watt-city/autonomous-stoplight/pcb_updates/katie_tao_stoplight/production/bom.csv

Designator | Footprint | Quantity | Value | LCSC Part #
C301, C402 | 0603 | 2 | 10u | C19702
C302, C304, C305 | 0603 | 3 | 100n | C14663
C303 | 0603 | 1 | 1u | C15849
C401 | 0805 | 1 | 4.7u | C1779
D201, D401, D402 | D_SOD-323_HandSoldering | 3 | 600m | C191023
D301 | 0805 | 1 | Green | C2297
D302 | 0603 | 1 | Red | C2286
D303 | 0805 | 1 | Yellow | C2296
J201 | USB4110-GF-A_GCT | 1 | USB4110-GF-A
J401 | CONN_S2B-PH-K-S_JST | 1 | S2B-PH-K-SLFSN
R201, R202 | 0805 | 2 | 5.1k | C27834
R301, R302, R303 | 0603 | 3 | 10k | C25804
R304 | 0805 | 1 | 47 | C17714
R305, R306 | 0805 | 2 | 120 | C17437
S301, S302, S303 | SW_TS-1088-AR02016 | 3 | TS-1088-AR02016
SW401 | 500SSP1_EWI | 1 | 500SSP1S2M2QEA
TP101 | TestPoint_Keystone_5019_Miniature | 1 | GND Test Point | C5199800
TP105 | TestPoint_Keystone_5019_Miniature | 1 | 3V3 Test Point | C5199800
TP201 | TestPoint_Keystone_5019_Miniature | 1 | USB Test Point | C5199800
TP401 | TestPoint_Keystone_5019_Miniature | 1 | LiPo Test Point | C5199800
U201 | SOT-23 | 1 | SLLC23T5V2U
U301 | ESP32-S3-WROOM-1_EXP | 1 | ESP32-S3-WROOM-1-N8
U401 | SOT-23-5 | 1 | AP2112K-3.3
