watt-city/autonomous-stoplight/pcb_updates/katie_tao_stoplight/katie_tao_stoplight.kicad_pcb

## KiCad design pcb_updates/katie_tao_stoplight/katie_tao_stoplight.kicad_pcb (2026-11-05)

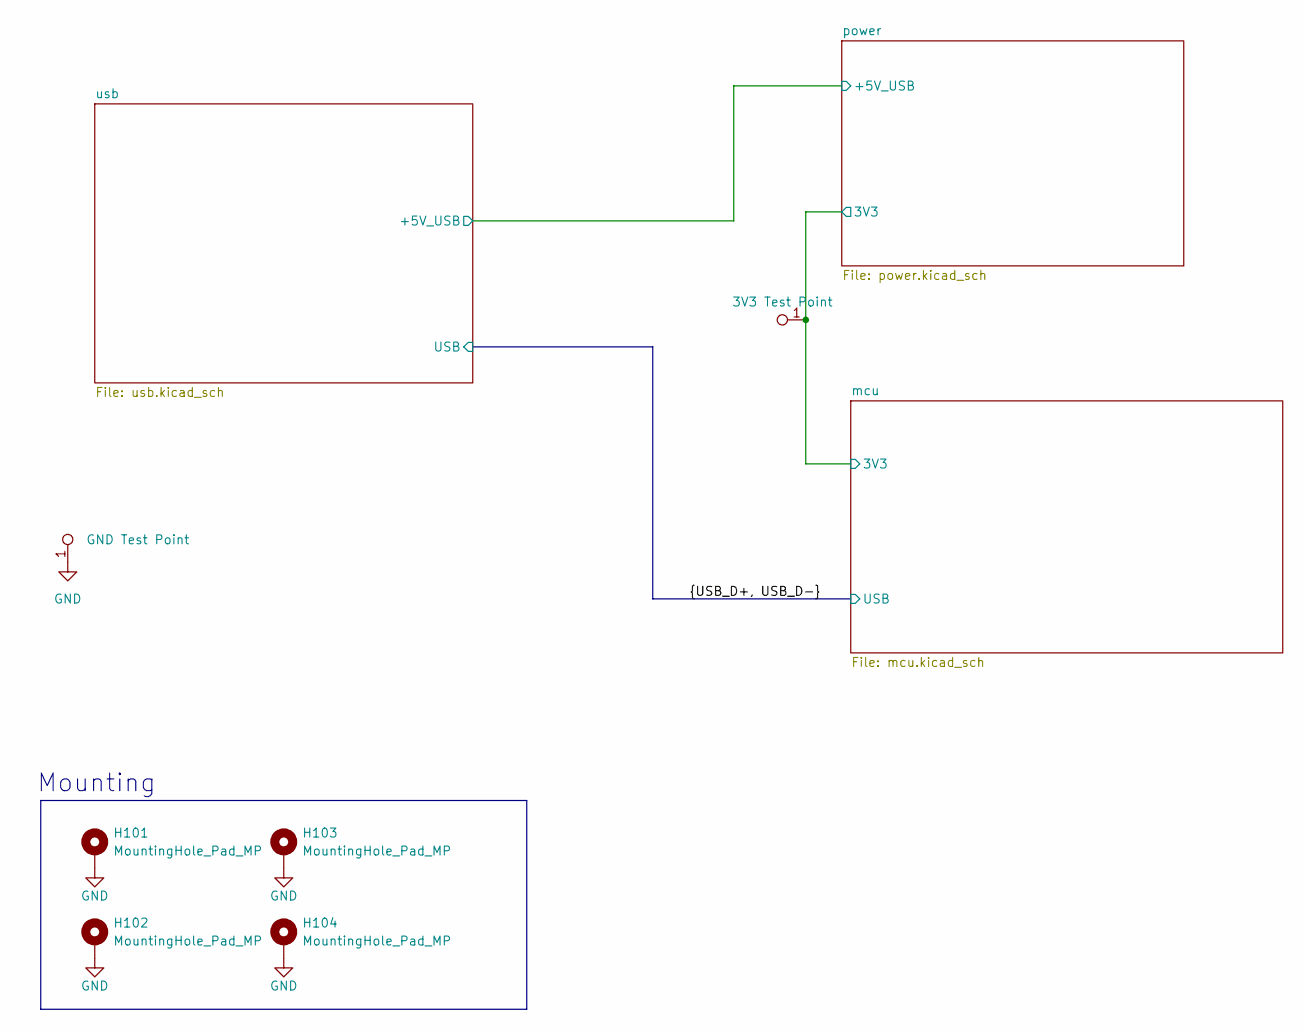
[picture p1: schematic katie_tao_stoplight.kicad_sch]

Parts:
H101, H102, H103, H104: MountingHole_Pad_MP; MountingHole_2.7mm_M2.5_Pad_Via; Mouser P/N N/A; Digikey P/N N/A
TP101: GND Test Point; TestPoint_Keystone_5019_Miniature; Manufacturer P/N RH-5019; Digikey P/N 36-5019CT-ND
TP105: 3V3 Test Point; TestPoint_Keystone_5019_Miniature; Manufacturer P/N RH-5019; Digikey P/N 36-5019CT-ND

Connections:
/mcu/3V3: TP105.1; also elsewhere on the board
GND: H101.1 (1_1), H102.1 (1_1), H103.1 (1_1), H104.1 (1_1), TP101.1; also elsewhere on the board

Notes on the sheet:
Mounting

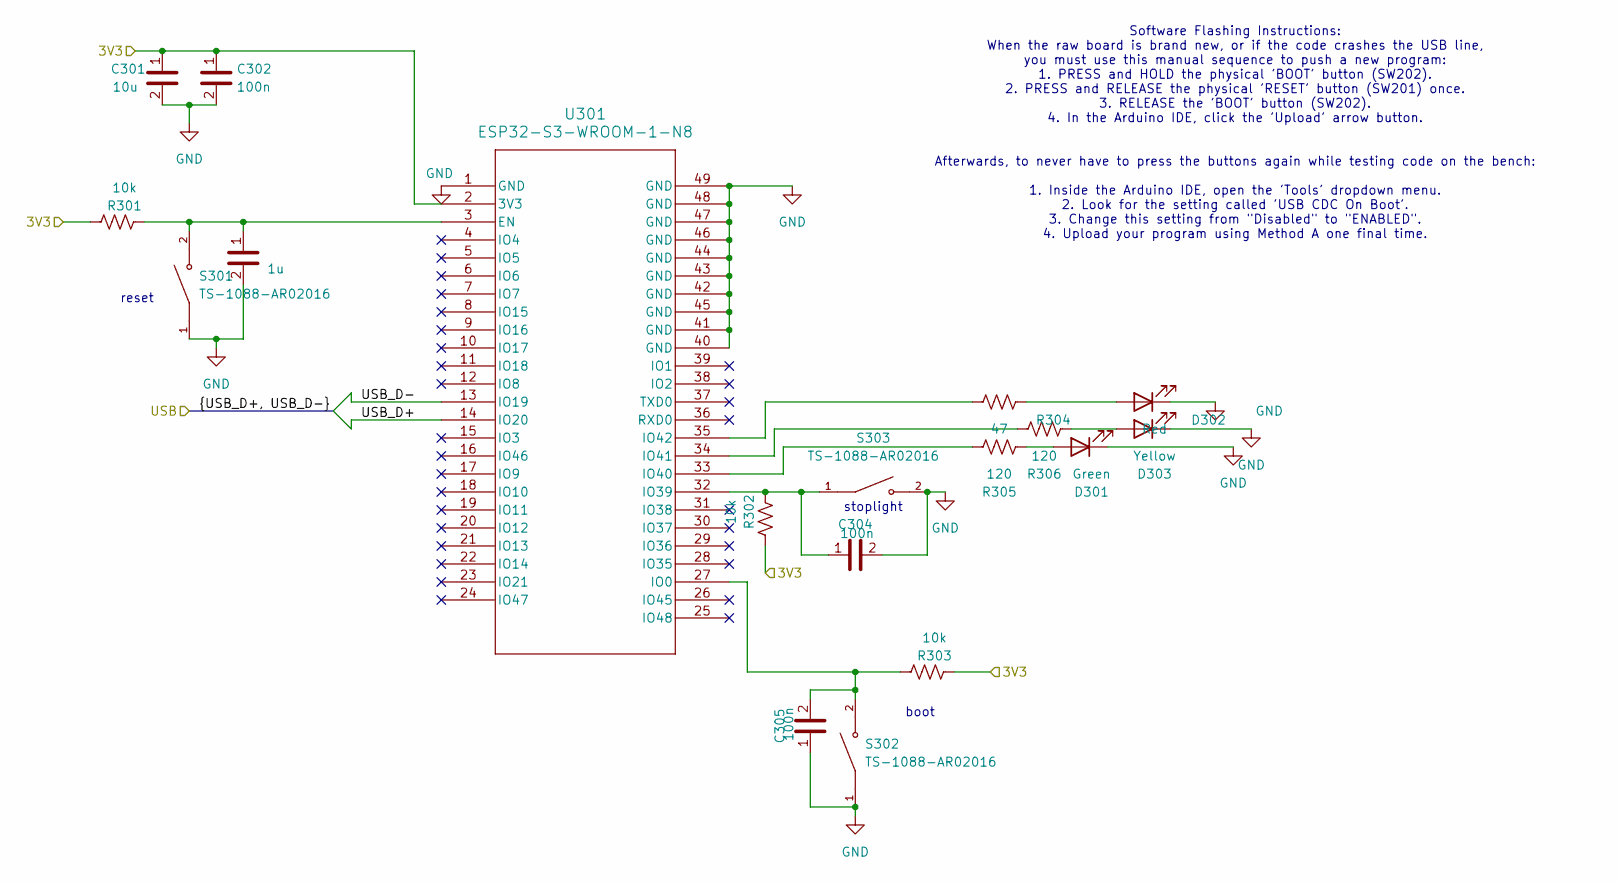
[picture p2: schematic mcu.kicad_sch]

Parts:
C301: 10u; C_0603_1608Metric_Pad1.08x0.95mm_HandSolder; LCSC P/N C19702
C302, C304, C305: 100n; C_0603_1608Metric_Pad1.08x0.95mm_HandSolder; Mouser P/N 581-06035C104KAT2A; Digikey P/N 478-KGM15BR71H104KTCT-ND
C303: 1u; C_0603_1608Metric_Pad1.08x0.95mm_HandSolder; LCSC P/N C15849
D301: Green; D_0805_2012Metric_Pad1.15x1.40mm_HandSolder; Mouser P/N 755-SMLMN2ECTT86C; Digikey P/N 846-SMLMN2ECTT86CCT-ND
D302: Red; D_0603_1608Metric_Pad1.05x0.95mm_HandSolder; Mouser P/N 720-LRQ976.01; Digikey P/N 475-LRQ976.01-P2R2-1CT-ND
D303: Yellow; D_0805_2012Metric_Pad1.15x1.40mm_HandSolder; Mouser P/N 645-599-0140-007F; Digikey P/N 350-4356-1-ND
R301, R302, R303: 10k; R_0603_1608Metric_Pad0.98x0.95mm_HandSolder; Mouser P/N 708-RMCF0603FT10K0; Digikey P/N RMCF0603FT10K0CT-ND
R304: 47; R_0805_2012Metric_Pad1.20x1.40mm_HandSolder; Mouser P/N 708-RMCF0805FT47R0; Digikey P/N RMCF0805FT47R0CT-ND
R305, R306: 120; R_0805_2012Metric_Pad1.20x1.40mm_HandSolder; Mouser P/N 708-RMCF0805FT120R; Digikey P/N RMCF0805FT120RCT-ND
S301, S302, S303: TS-1088-AR02016; SW_TS-1088-AR02016; PARTREV N/A
U301: ESP32-S3-WROOM-1-N8; ESP32-S3-WROOM-1_EXP

Connections:
/USB_D+: U301.14 (IO20); also elsewhere on the board
/USB_D-: U301.13 (IO19); also elsewhere on the board
/mcu/3V3: C301.1, C302.1, R301.1, R302.1, R303.2, U301.2 (3V3); also elsewhere on the board
GND: C301.2, C302.2, C303.2, C304.2, C305.1, D301.1 (K), D302.1 (K), D303.1 (K), S301.1, S302.1, S303.2, U301.1 (GND), U301.40 (GND), U301.41 (GND), U301.42 (GND), U301.43 (GND), U301.44 (GND), U301.45 (GND), U301.46 (GND), U301.47 (GND), U301.48 (GND), U301.49 (GND); also elsewhere on the board
unnamed: D301.2 (A), R305.1
unnamed: D302.2 (A), R304.1
unnamed: D303.2 (A), R306.1
unnamed: C303.1, R301.2, S301.2, U301.3 (EN)
unnamed: C305.2, R303.1, S302.2, U301.27 (IO0)
unnamed: C304.1, R302.2, S303.1, U301.32 (IO39)
unnamed: R305.2, U301.33 (IO40)
unnamed: R306.2, U301.34 (IO41)
unnamed: R304.2, U301.35 (IO42)

Notes on the sheet:
reset
Software Flashing Instructions: When the raw board is brand new, or if the code crashes the USB line, you must use this manual sequence to push a new program: 1. PRESS and HOLD the physical 'BOOT' button (SW202). 2. PRESS and RELEASE the physical 'RESET' button (SW201) once. 3. RELEASE the 'BOOT' b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
boot
stoplight

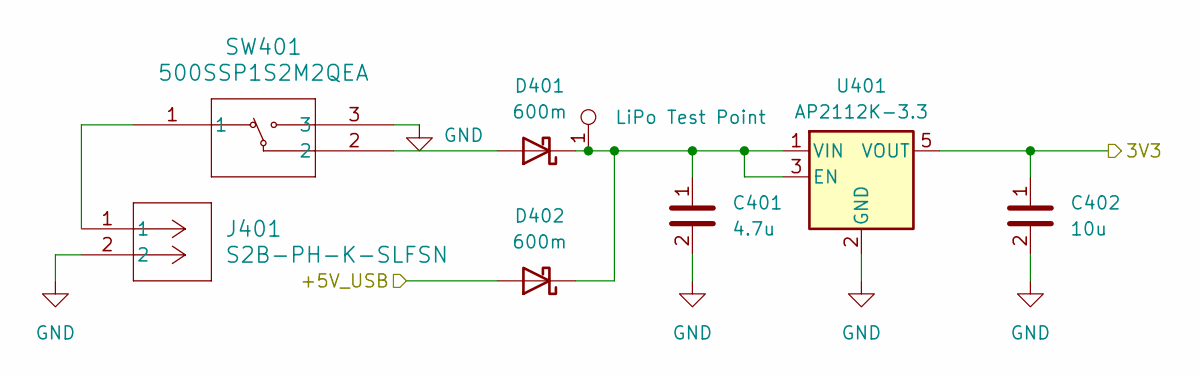
[picture p3: schematic power.kicad_sch]

Parts:
C401: 4.7u; C_0805_2012Metric_Pad1.18x1.45mm_HandSolder; Mouser P/N 581-KGM21AR51A475KU; Digikey P/N 478-KGM21AR51A475KUCT-ND
C402: 10u; C_0603_1608Metric_Pad1.08x0.95mm_HandSolder; LCSC P/N C19702
D401, D402: 600m; D_SOD-323_HandSoldering; Mouser P/N 833-B5819WS-TP; LCSC P/N C191023
J401: S2B-PH-K-SLFSN; CONN_S2B-PH-K-S_JST
SW401: 500SSP1S2M2QEA; 500SSP1_EWI
TP401: LiPo Test Point; TestPoint_Keystone_5019_Miniature; Manufacturer P/N RH-5019; Digikey P/N 36-5019CT-ND
U401: AP2112K-3.3; SOT-23-5

Connections:
/mcu/3V3: C402.1, U401.5 (VOUT); also elsewhere on the board
/power/+5V_USB: D402.2 (A); also elsewhere on the board
GND: C401.2, C402.2, J401.2, SW401.3, U401.2 (GND); also elsewhere on the board
unnamed: D401.2 (A), SW401.2
unnamed: C401.1, D401.1 (K), D402.1 (K), TP401.1, U401.1 (VIN), U401.3 (EN)
unnamed: J401.1, SW401.1

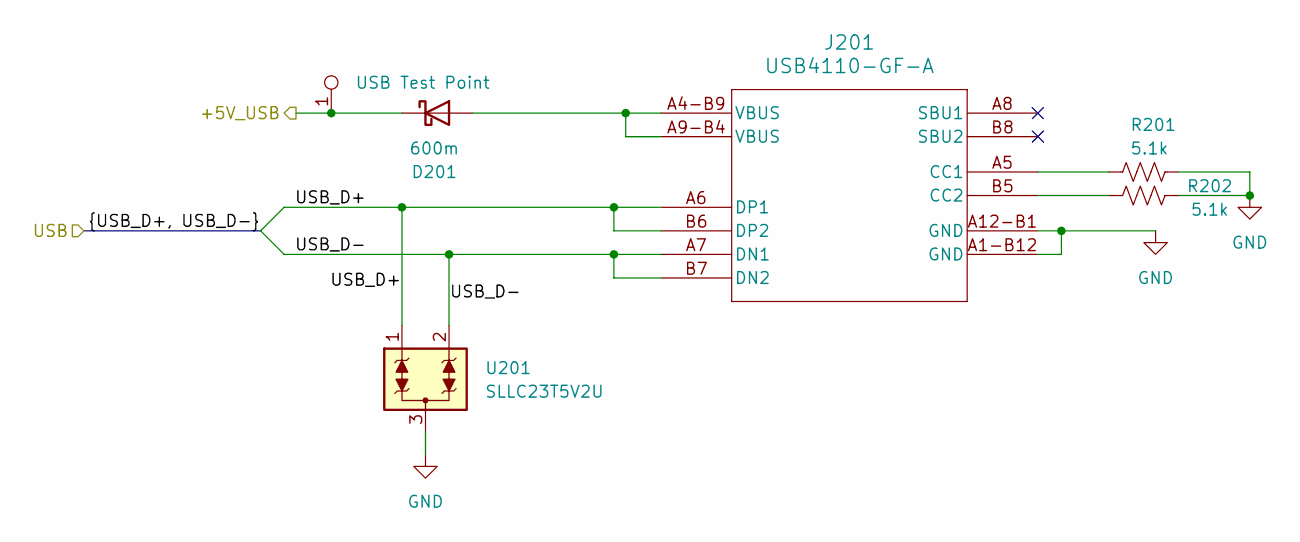
[picture p4: schematic usb.kicad_sch]

Parts:
D201: 600m; D_SOD-323_HandSoldering; Mouser P/N 833-B5819WS-TP; LCSC P/N C191023
J201: USB4110-GF-A; USB4110-GF-A_GCT
R201, R202: 5.1k; R_0805_2012Metric_Pad1.20x1.40mm_HandSolder; Mouser P/N 708-RMCF0805FT5K10; Digikey P/N RMCF0805FT5K10CT-ND
TP201: USB Test Point; TestPoint_Keystone_5019_Miniature; Manufacturer P/N RH-5019; Digikey P/N 36-5019CT-ND
U201: SLLC23T5V2U; SOT-23; Manufacturer P/N SLLC23T5V2U; Digikey P/N 5399-SLLC23T5V2UCT-ND

Connections:
/USB_D+: J201.A6 (DP1), J201.B6 (DP2), U201.1; also elsewhere on the board
/USB_D-: J201.A7 (DN1), J201.B7 (DN2), U201.2; also elsewhere on the board
/power/+5V_USB: D201.1 (K), TP201.1; also elsewhere on the board
GND: J201.A1-B12 (GND), J201.A12-B1 (GND), R201.1, R202.1, U201.3; also elsewhere on the board
unnamed: D201.2 (A), J201.A4-B9 (VBUS), J201.A9-B4 (VBUS)
unnamed: J201.A5 (CC1), R201.2
unnamed: J201.B5 (CC2), R202.2

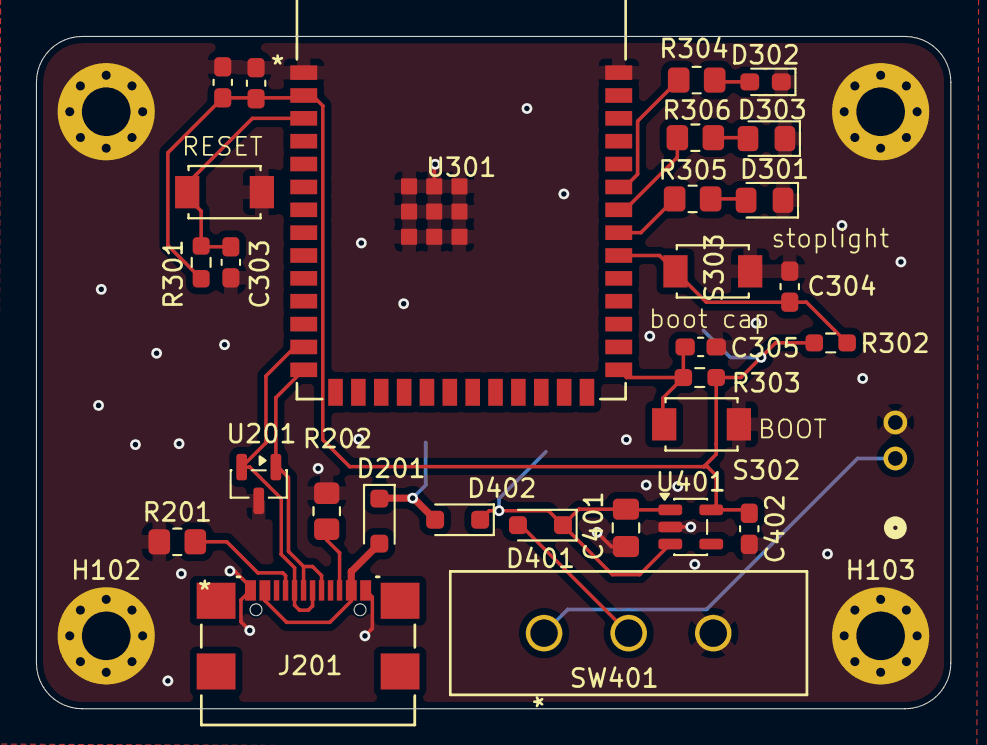
[picture p5: board katie_tao_stoplight.kicad_pcb from above]

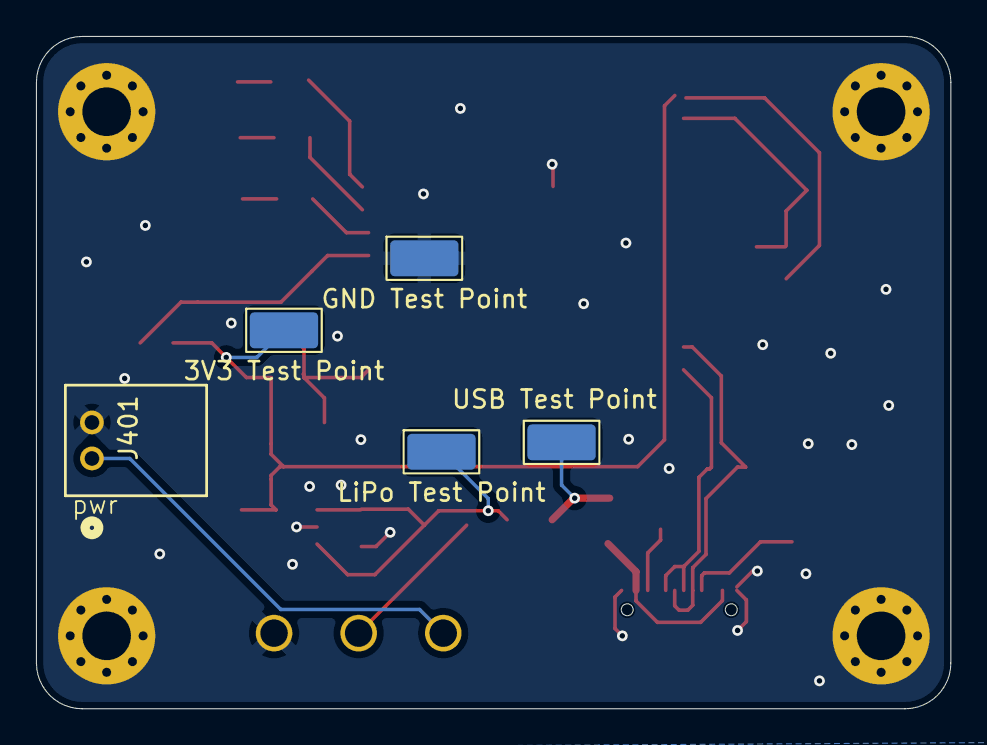
[picture p6: board katie_tao_stoplight.kicad_pcb from below]

Board: 2 copper layers, 50.8 x 37.3 mm, 38 parts (5 on the bottom side), 20 nets.
