watt-city/autonomous-stoplight/(commit log)

2026-07-25 changed to buck
    [bom.csv, designators.csv, positions.csv, power.kicad_sch, usb.kicad_sch, watt_city_stoplight_pcb.kicad_pcb, watt_city_stoplight_pcb.kicad_sch]
2026-07-25 added production files
    [power.kicad_sch]
2026-08-02 Restore LDO baseline and apply latest schematic and layout updates
    [mcu.kicad_sch, power.kicad_sch, watt_city_stoplight_pcb.kicad_pcb]
2026-08-05 finalized version
    [bom.csv, designators.csv, positions.csv, power.kicad_sch, watt_city_stoplight_pcb.kicad_pcb]
2026-08-15 refactored repo
    [bom.csv, designators.csv, mcu.kicad_sch, positions.csv, power.kicad_sch, usb.kicad_sch, watt_city_stoplight_pcb.kicad_pcb, watt_city_stoplight_pcb.kicad_sch]
2026-10-13 Remove KiCad backups, lock files, and duplicate production.zip
    - Delete KiCad autosave zips, lock files and per-user .kicad_prl
    - Delete hardware/production.zip: the Gerber zip inside is byte-identical
    to hardware/production/watt_city_stoplight_pcb.zip and the CSV/IPC
    files differ only in line endings. hardware/production/ stays as the
    fab record.
    - Add .gitignore so these don't come back
    Claude-Session: https://claude.ai/code/session_01Wnp1WRYzGuosmDiJwmEC77
2026-10-13 Add README, CONTRIBUTING guide, and PR template
    README covers what the repo is, layout, setup, pin map, and known
    issues. CONTRIBUTING describes the branch + pull request workflow,
    KiCad and secrets rules. The PR template asks how changes were tested
    and what AI was used for.
    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
2026-11-04 README: point to the buck design's commit in main's history
    The buck_version branch only added a KiCad autosave and lock-file changes;
    the buck design itself is d3aed35 on main.
    Claude-Session: https://claude.ai/code/session_01GRghf5Mnk8s65SVmit5dcY
2026-11-05 README: point to the archive/buck_version tag for the TPS63070 design
    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
2026-11-05 made folder for pcbs
    [bom.csv, designators.csv, katie_tao_stoplight.kicad_pcb, katie_tao_stoplight.kicad_sch, mcu.kicad_sch, positions.csv, power.kicad_sch, usb.kicad_sch]
